Uselessful/kukozhpad/README.md

# Kukozhpad
A simple 4x4 keypad utilizing Pro Micro and QMK

## Photos
*With joric's crkbd fork – [Jorne](https://github.com/joric/jorne):*
kukozhpad_and_jorne_top
*Height comparison:*
kukozhpad_and_jorne_height
from_side
from_side_2
bottom
pcb_closeup
pcb_front
pcb_back
