Uselessful/kukozhpad/(threads)

Thread 1 (2020-06-25):

Minor misalignment of top left standoff hole in PCB

Uselessful, 2020-06-25:
Not too bad, but the looks of it as is are quite disturbing
